hgq6yt44wz-sudo/PID-Balancers/PID_Images/Block2.JPG

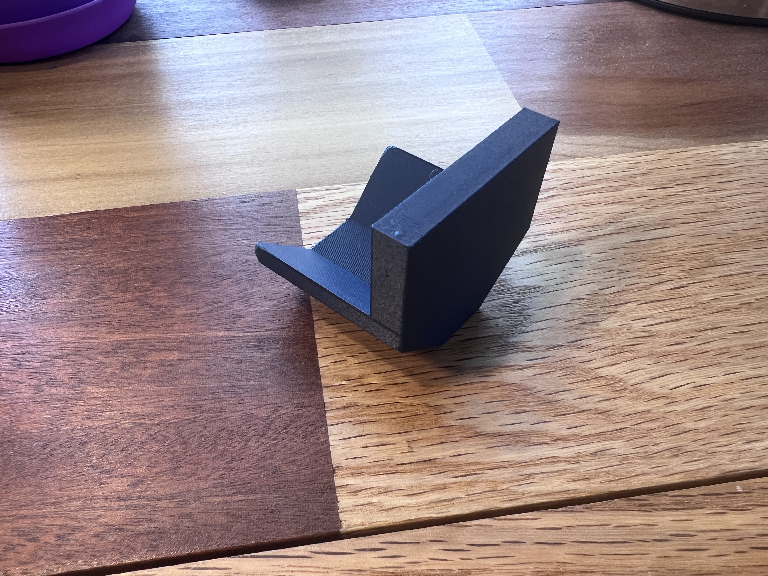
PID_Images/Block2.JPG
