hgq6yt44wz-sudo/PID-Balancers/STL_Files/Assembly.stl

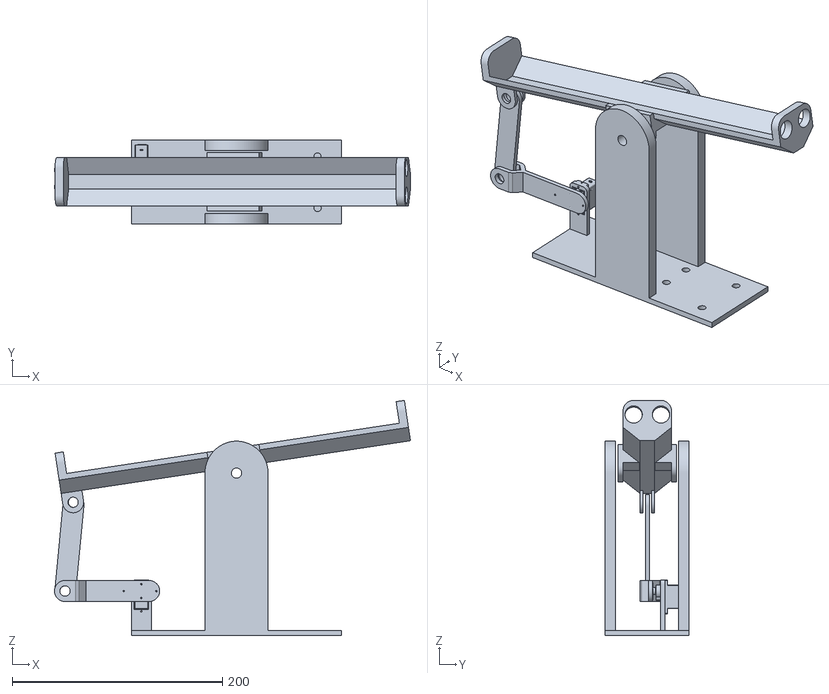
[picture p16: CAD file, 2026-05-26]
STL_Files/Assembly.stl
338.6 x 80.0 x 223.7
