hgq6yt44wz-sudo/PID-Balancers/STL_Files/Balance_Beam.stl

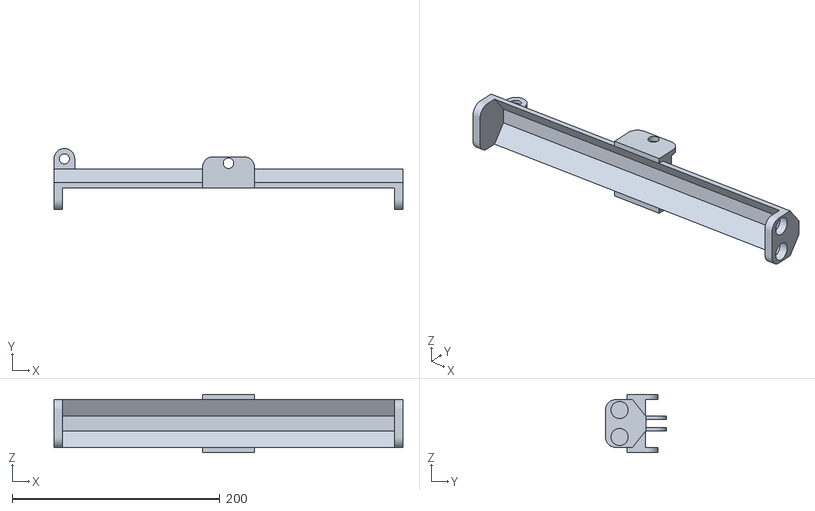
[picture p17: CAD file, 2026-05-26]
STL_Files/Balance_Beam.stl
336.0 x 58.8 x 56.0
