hgq6yt44wz-sudo/PID-Balancers/STL_Files/100mm_Connector.stl

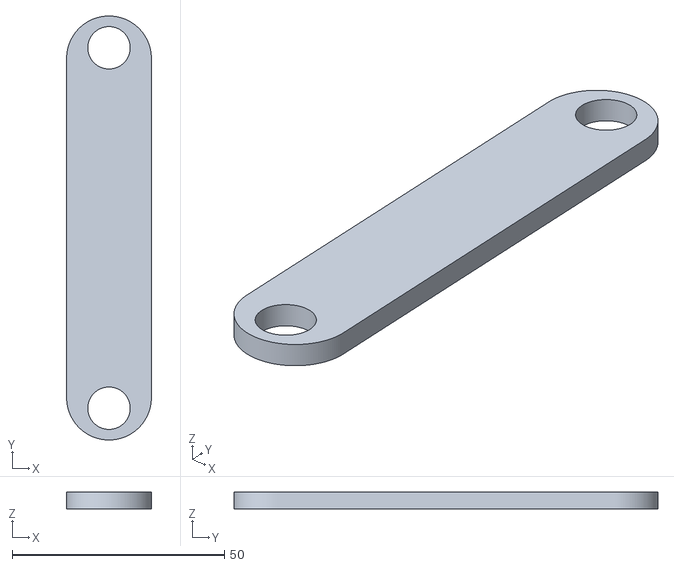
[picture p18: CAD file, 2026-05-26]
STL_Files/100mm_Connector.stl
20.0 x 100.0 x 4.00
