hgq6yt44wz-sudo/PID-Balancers/STL_Files/Servo_ExtensionArm.stl

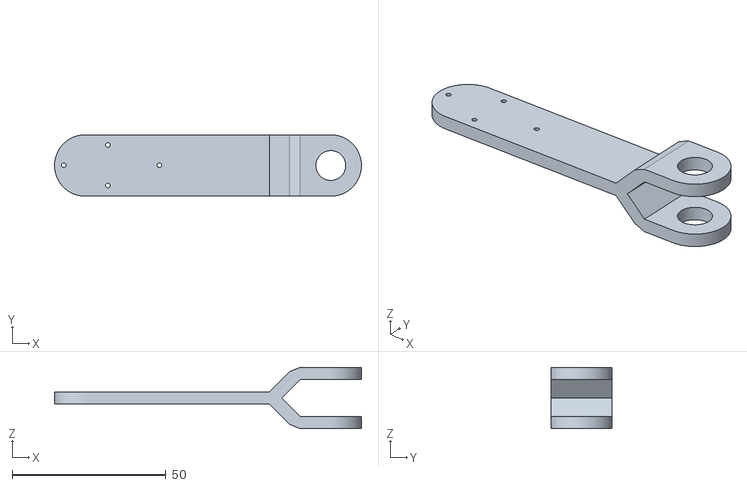
[picture p19: CAD file, 2026-05-26]
STL_Files/Servo_ExtensionArm.stl
100.0 x 20.0 x 20.0
