hgq6yt44wz-sudo/PID-Balancers/STL_Files/Base.stl

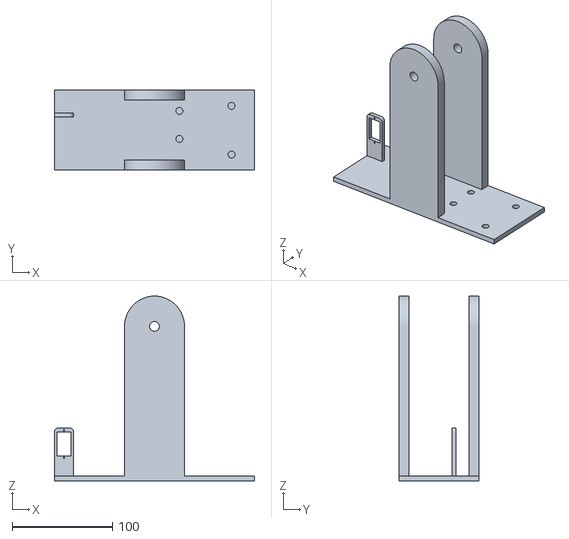
[picture p20: CAD file, 2026-05-26]
STL_Files/Base.stl
200.0 x 80.0 x 185.0
