hgq6yt44wz-sudo/PID-Balancers/PID_Images/StressBall.JPG

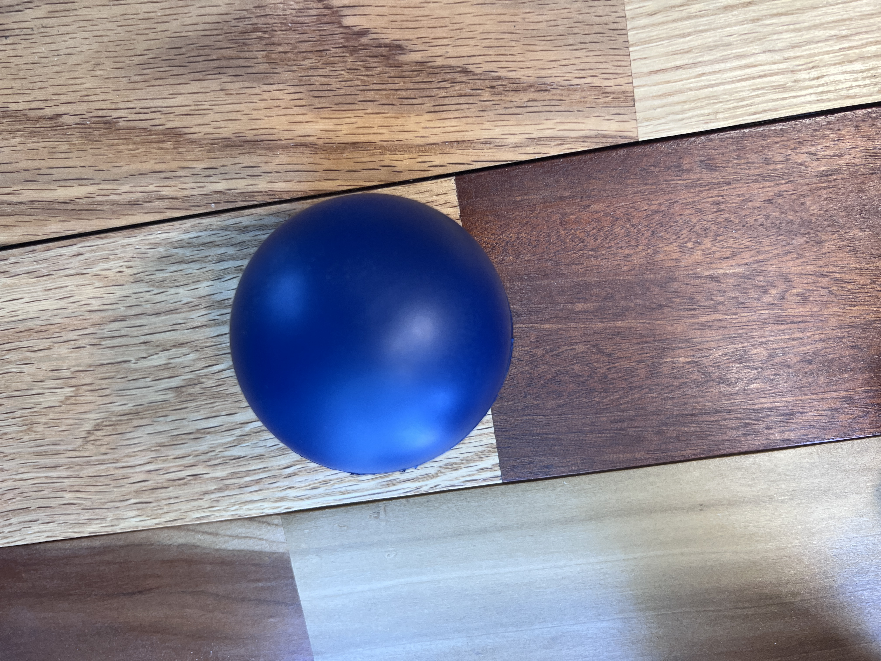
PID_Images/StressBall.JPG
